fra-blo/radio/images/README.md

## Images showing radio hardware, software or radio schematics
