fra-blo/radio/images/Radio_general_view_2.jpg

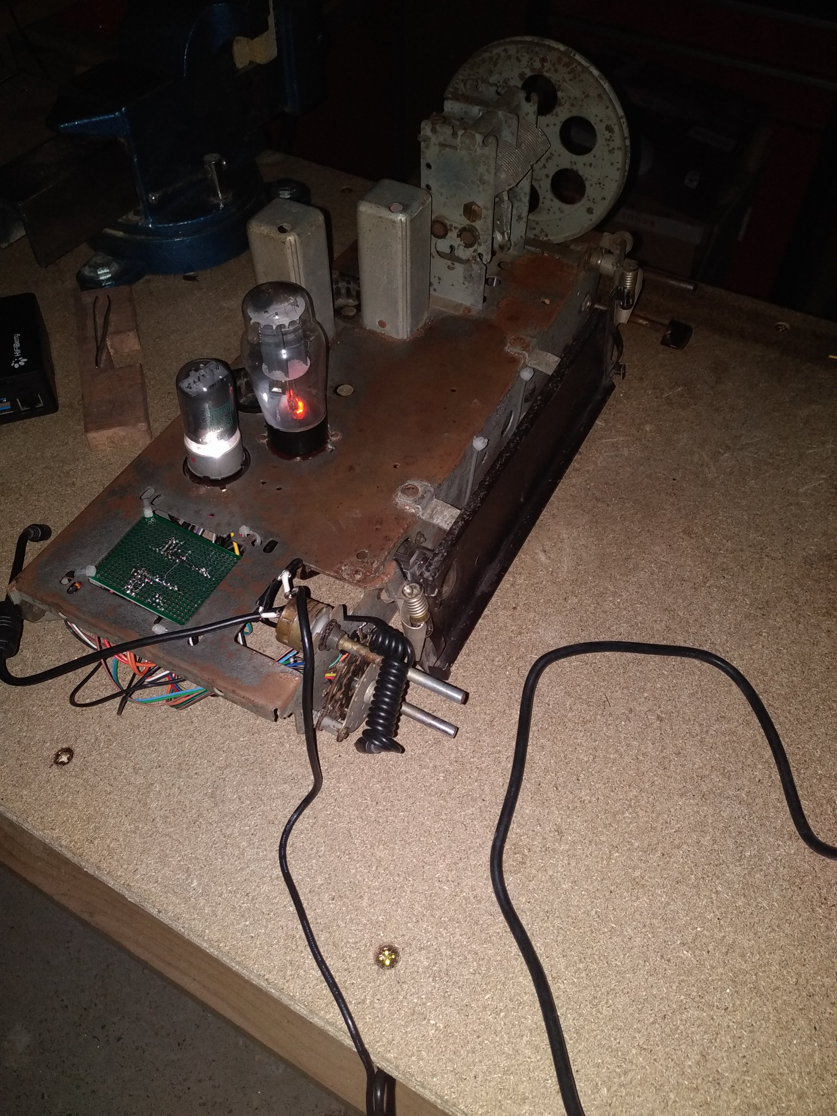
images/Radio_general_view_2.jpg
