fra-blo/radio/images/radio_leds_on.jpg

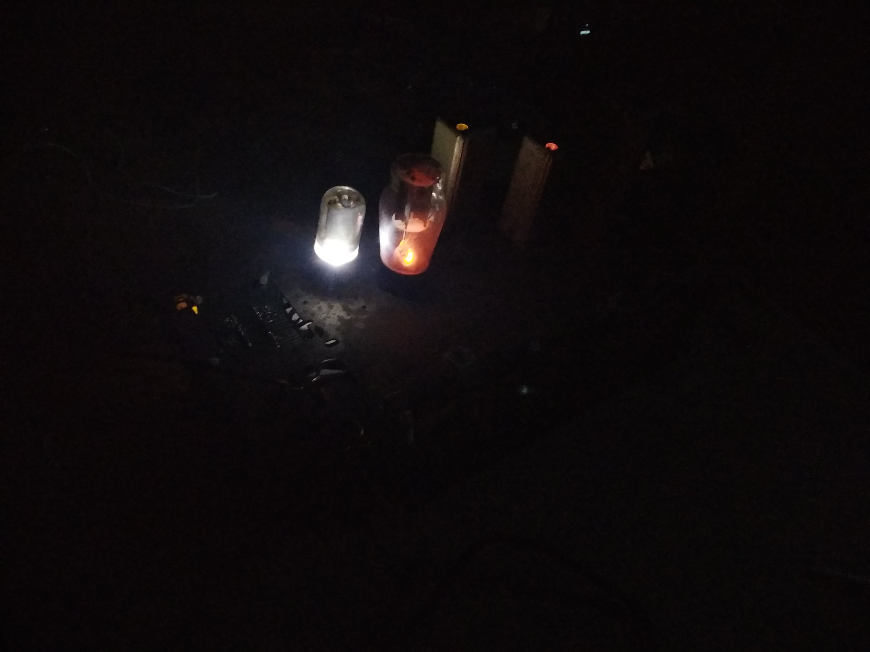
images/radio_leds_on.jpg
