fra-blo/radio/images/radio_leds_on_2.jpg

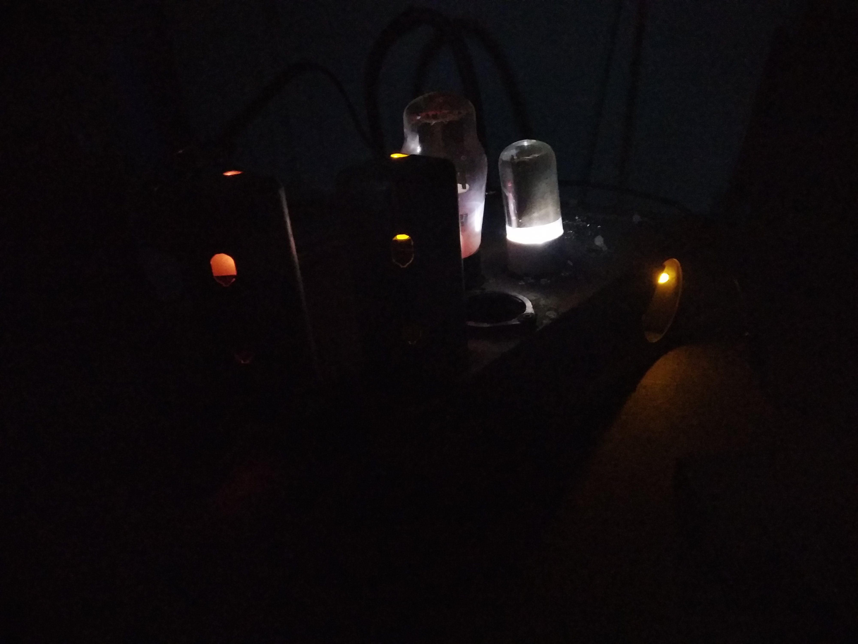
images/radio_leds_on_2.jpg
