fra-blo/radio/images/radio_left_buttons.jpg

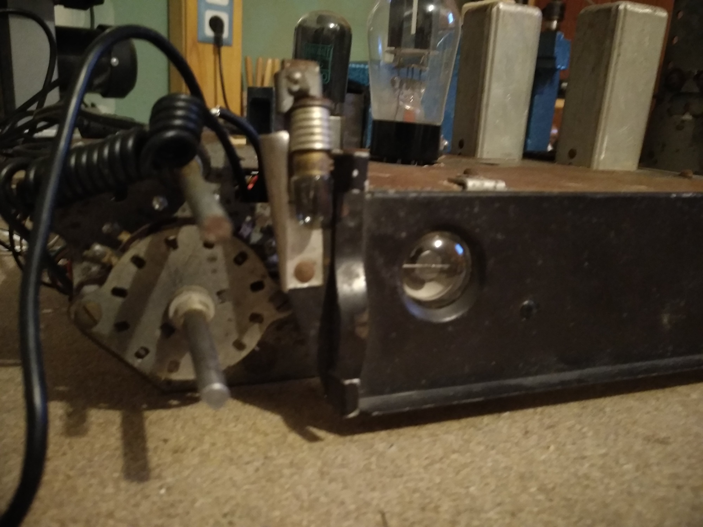
images/radio_left_buttons.jpg
