fra-blo/radio/images/radio_right_button.jpg

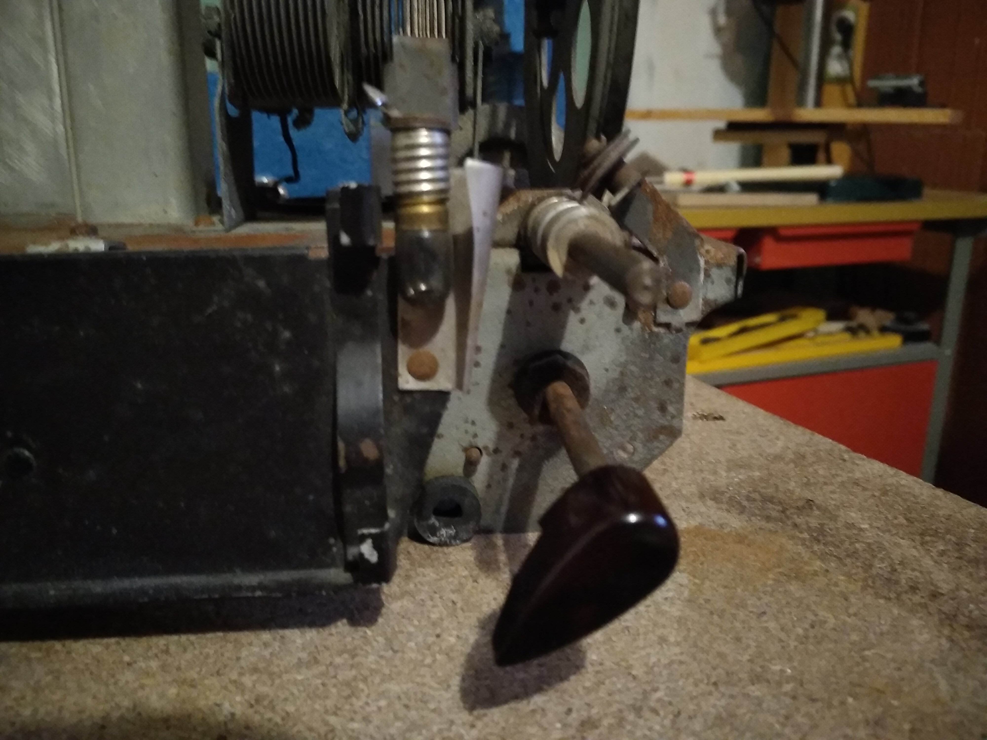
images/radio_right_button.jpg
