fra-blo/radio/images/radio_voltage_selector.jpg

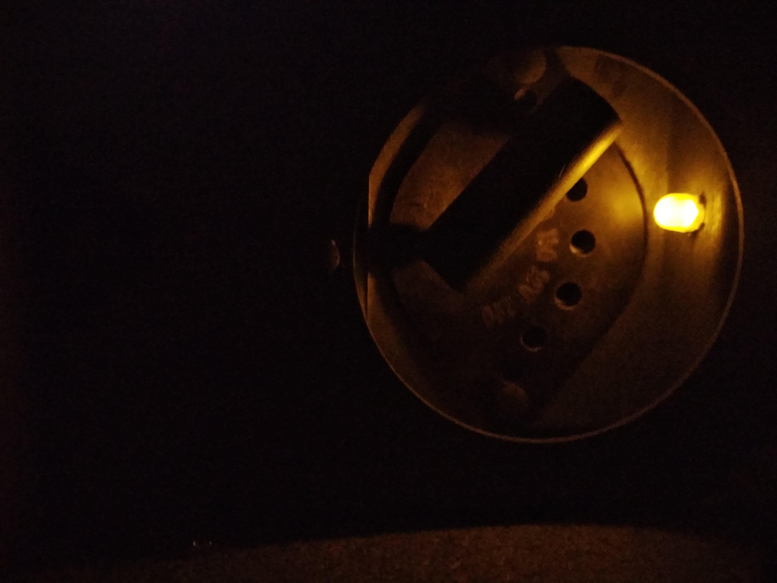
images/radio_voltage_selector.jpg
