fra-blo/radio/images/under_radio_2.jpg

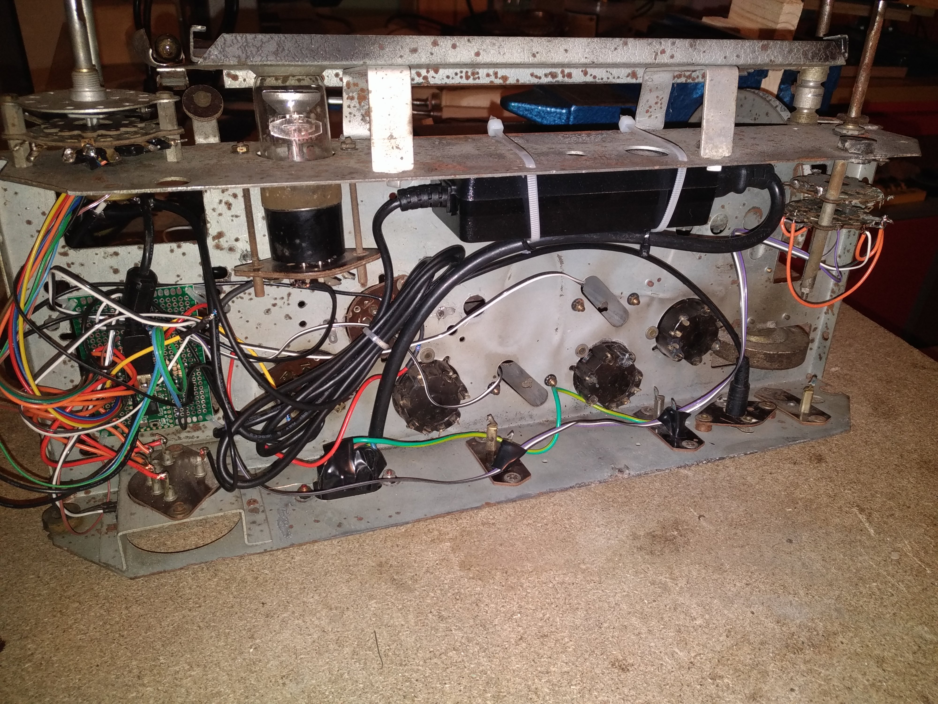
images/under_radio_2.jpg
