fra-blo/radio/images/under_radio_zoom.jpg

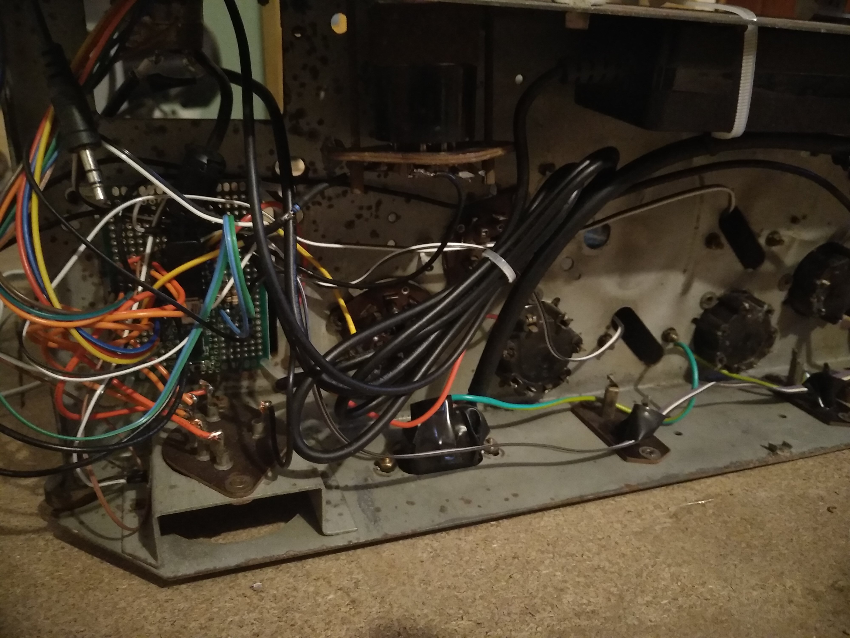
images/under_radio_zoom.jpg
